cuillerj/Thermostat/(list of files, drawings)

Other design files:
thermostatElectronicDesign.fzz
thermostatPower.fzz
