cuillerj/Thermostat/ComputePID.ino

void ComputePid()
{
  if (dataPID[0] == 0 && AverageTemp() != noTempAvailable) // first time init dataPID
  {
#if defined(debugPID)
    Serial.println("init PID Data");
#endif
    for (int i = 0; i < PIDDataSize; i++)
    {
      dataPID[i] = int(AverageTemp() * 10); // init
    }
  }
  sigmaE = 0;
  if (AverageTemp() != noTempAvailable)
  {
    dataPID[PIDCycle % PIDDataSize] = int(AverageTemp() * 10);
    int target = int(tempInstruction * 10);
#if defined(debugPID)
    Serial.print("PID cycle:");
    Serial.print(PIDCycle % PIDDataSize);
    Serial.print(" data:");
    Serial.print(dataPID[PIDCycle % PIDDataSize]);
    Serial.print(" target:");
    Serial.print(target);
#endif
    int proportionalTerm = (thermostatRegister[KpPIDRegister] * (target - dataPID[PIDCycle]));
    for (int i = 0; i < PIDDataSize; i++) {
      sigmaE = sigmaE + target - dataPID[i];
    }
    if (prevTarget != int(tempInstruction * 10))
    {
      sigmaPrec = sigmaE;
      prevTarget = int(tempInstruction * 10);
    }
    int derivativeTerm = ((sigmaE - sigmaPrec) * thermostatRegister[KdPIDRegister]);
    int integralTerm = (sigmaE * KiPIDRegister) / 5;
    windowSize = (proportionalTerm + integralTerm + derivativeTerm) / 10;
#if defined(debugPID)
    Serial.print(" window:");
    Serial.println(windowSize);
#endif
  }
}

void SwitchPID ()
{
  PIDCycle = (PIDCycle + 1) % PIDDataSize;
  sigmaPrec = sigmaE;
  if (PIDRequest)
  {
    SendPID();
  }
}
