cuillerj/Thermostat/(commit log)

2017-11-21 first reliable version
    [thermostatElectronic.fzz, thermostatElectronicv2.fzz]
2017-12-09 improve debug options
    [thermostatElectronicv3.fzz, thermostatPower.fzz]
2017-12-12 update electronic documentation
    [thermostatElectronicDesign.fzz, thermostatPower.fzz]
2017-12-17 improve documentation
    [thermostatElectronic.fzz, thermostatElectronicDesign.fzz, thermostatElectronicv2.fzz, thermostatElectronicv3.fzz, thermostatPower.fzz]
2018-01-08 Documentation updated
    [thermostatElectronicDesign.fzz]
2018-02-18 Anticipation improvment
    anticipation calculation modified to fit with actual behaviour
    schedule index is reported in status frame
2018-04-08 current temperature sent with 2 bytes
2018-11-29 add lcdinit to get round noise
    [InfraRed.ino, Thermostat.ino]
